grantminer/keep-it-synth-le-stupid/Diagrams/BasicBlock.jpeg

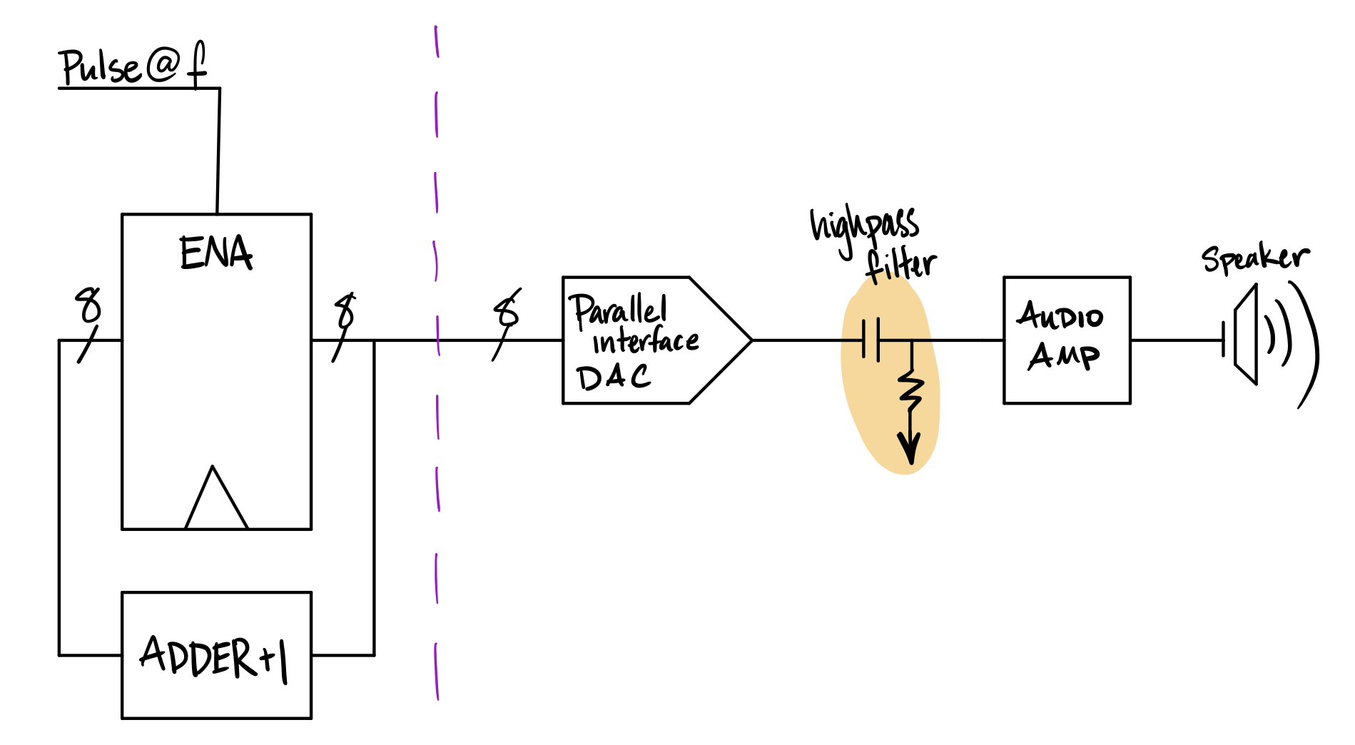
Diagrams/BasicBlock.jpeg
