grantminer/keep-it-synth-le-stupid/wave_generators/triangle_wave.sv

// Based on triangle_genenrator.sv from olin-cafe-f21/02_solutions
// Generates "triangle" waves (counts from 0 to 2^N-1, then back down again)
// The triangle should increment/decrement only if the ena signal is high, and hold its value otherwise.
module triangle_wave (clk, rst, ena, out);

parameter N = 8;
input wire clk, rst, ena;
output logic [N-1:0] out;

typedef enum logic {COUNTING_UP, COUNTING_DOWN} state_t;
state_t state;

always_ff @(posedge clk) begin
  if(rst) begin
    out <= 0;
    state <= COUNTING_UP;
  end else if (ena) begin
    case(state)
      COUNTING_UP: begin
        out <= out + 1;
        if(&out[N-1:1] & ~out[0]) state <= COUNTING_DOWN;
      end
      COUNTING_DOWN: begin
        out <= out -1;
        if(&({~out[N-1:1],out[0]})) state <= COUNTING_UP;
      end
    endcase
  end
end

endmodule
