grantminer/keep-it-synth-le-stupid/(commit log)

2021-12-06 Fix file names, saw wave and test working
    [saw_wave.sv, square_wave.sv, triangle_wave.sv]
2021-12-12 Fix main and test_main errors.
    [main.sv, test_main.sv]
